alexcustos/attwlight-sensor/attwlight_sensor.pcb/attwlight_sensor.pdf

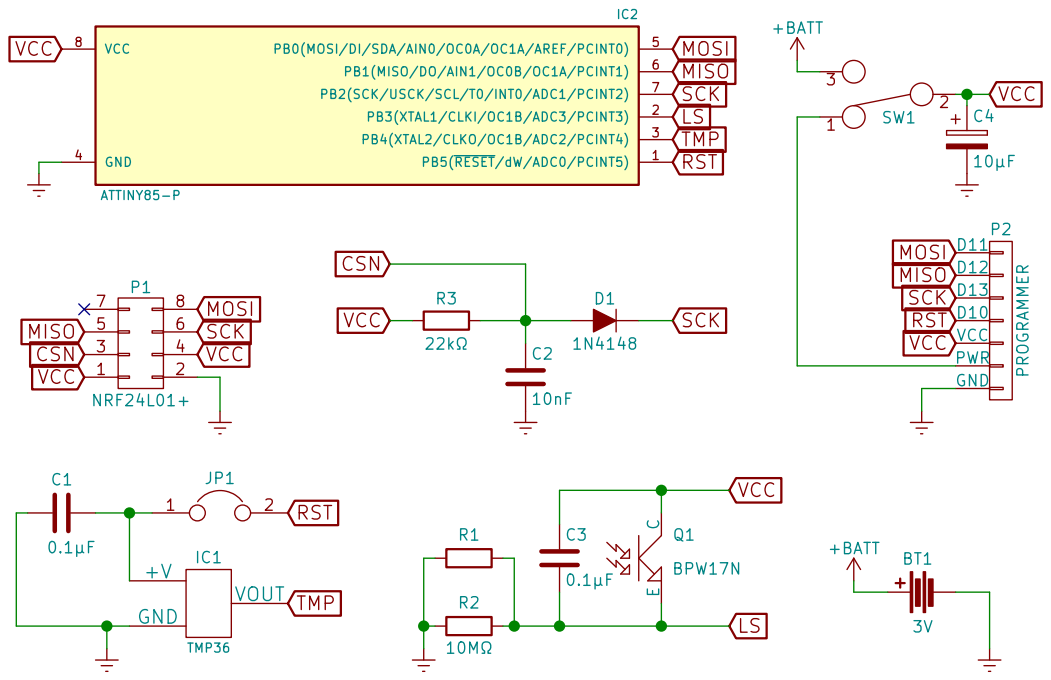
[picture p1: page 1]
