alexcustos/attwlight-sensor/attwlight_sensor.pcb/attwlight_sensor.kicad_pcb

## KiCad design attwlight_sensor.pcb/attwlight_sensor.kicad_pcb (2015-12-17)

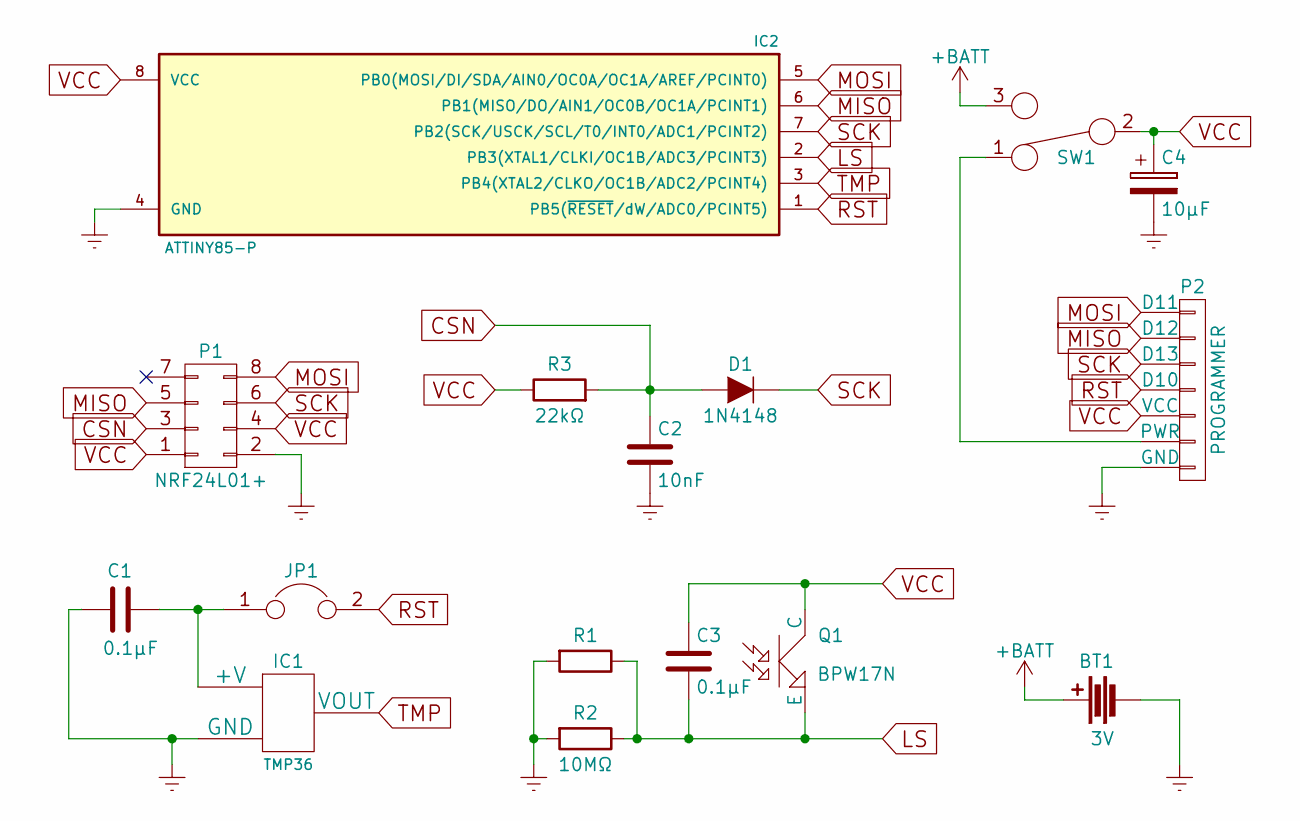
[picture p2: schematic attwlight_sensor.sch]

Parts:
BT1: 3V; CR2032V
C1, C3: 0.1μF; C_Disc_D6_P5
C2: 10nF; C_Disc_D6_P5
C4: 10μF; C_Radial_D5_L6_P2.5
D1: 1N4148; Diode_DO-35_SOD27_Horizontal_RM10
IC1: TMP36; TO-92_Inline_Wide
IC2: ATTINY85-P; DIP-8_W7.62mm
JP1: JUMPER; Pin_Header_Straight_1x02
P1: NRF24L01+; Socket_Strip_Straight_2x04
P2: PROGRAMMER; Pin_Header_Straight_1x07
Q1: BPW17N
R1: R; Resistor_Horizontal_RM10mm
R2: 10MΩ; Resistor_Horizontal_RM10mm
R3: 22kΩ; Resistor_Horizontal_RM10mm
SW1: Switch_SPDT; SW_Micro_SPST

Connections:
+BATT: BT1.1, SW1.3 (C)
CSN: C2.1, D1.2 (A), P1.3, R3.2
Earth: BT1.2, C1.1, C2.2, C4.2, IC1.3 (GND), IC2.4 (GND), P1.2, P2.7 (GND), R1.2, R2.2
LS: C3.2, IC2.2 (PB3(XTAL1/CLKI/OC1B/ADC3/PCINT3)), Q1.2 (E), R1.1, R2.1
MISO: IC2.6 (PB1(MISO/DO/AIN1/OC0B/OC1A/PCINT1)), P1.5, P2.2 (D12)
MOSI: IC2.5 (PB0(MOSI/DI/SDA/AIN0/OC0A/OC1A/AREF/PCI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), P1.8, P2.1 (D11)
unnamed: C1.2, IC1.1 (+V), JP1.1
unnamed: P2.6 (PWR), SW1.1 (A)
RST: IC2.1 (PB5(~RESET~/dW/ADC0/PCINT5)), JP1.2, P2.4 (D10)
SCK: D1.1 (K), IC2.7 (PB2(SCK/USCK/SCL/T0/INT0/ADC1/PCINT2)), P1.6, P2.3 (D13)
TMP: IC1.2 (VOUT), IC2.3 (PB4(XTAL2/CLKO/OC1B/ADC2/PCINT4))
VCC: C3.1, C4.1, IC2.8 (VCC), P1.1, P1.4, P2.5 (VCC), Q1.1 (C), R3.1, SW1.2 (B)

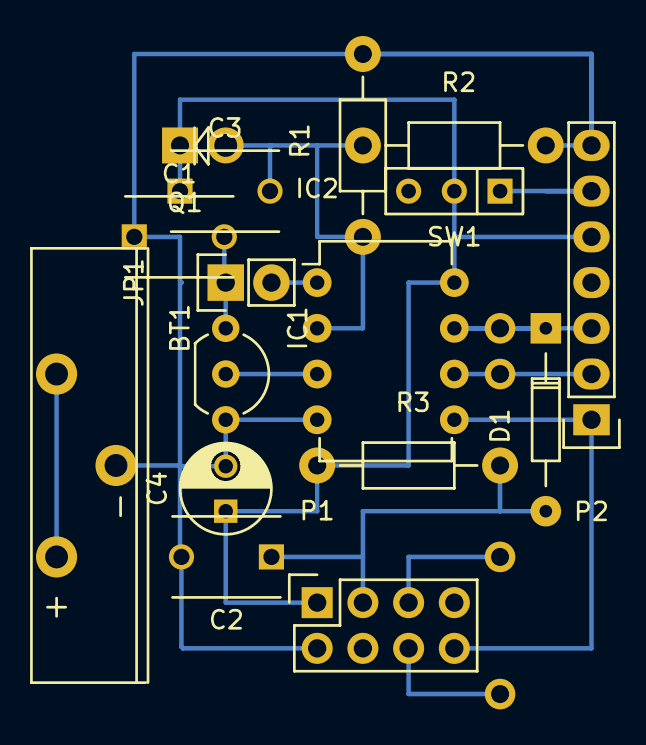
[picture p3: board attwlight_sensor.kicad_pcb from above]

Board: 2 copper layers, 16 parts (0 on the bottom side), 12 nets.
